JanithChandula/Weight_Scale/20200301_212428.jpg

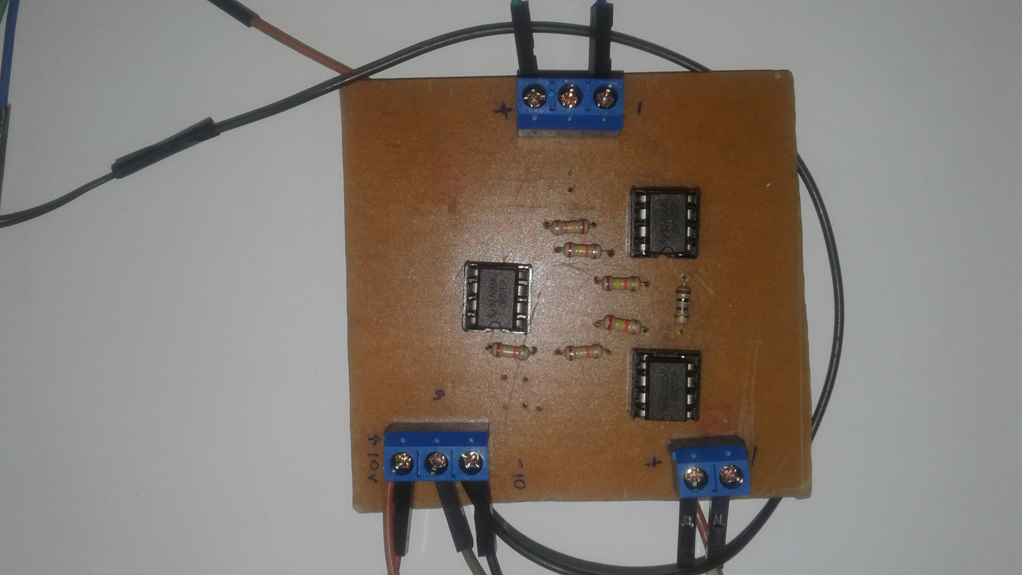
20200301_212428.jpg
