JanithChandula/Weight_Scale/20200221_163328.jpg

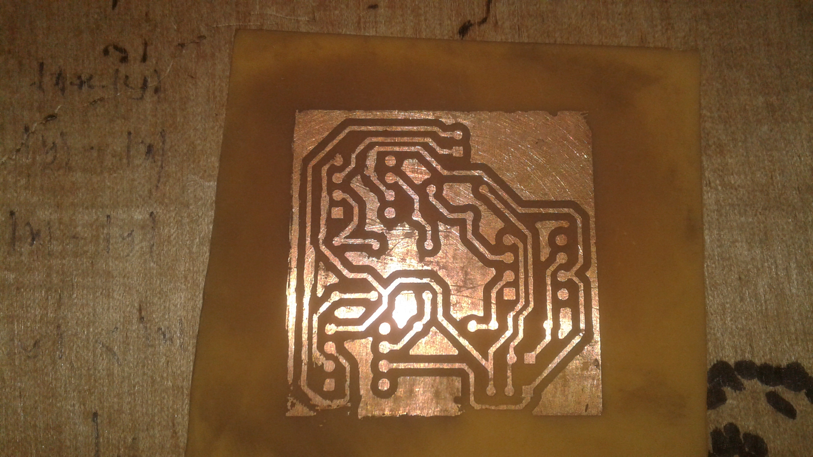
20200221_163328.jpg
