JanithChandula/Weight_Scale/README.md

# Weight_Scale
Developed a weight scale using Atmega 328p to measure weight up to 5 kg
