JanithChandula/Weight_Scale/20200222_132628.jpg

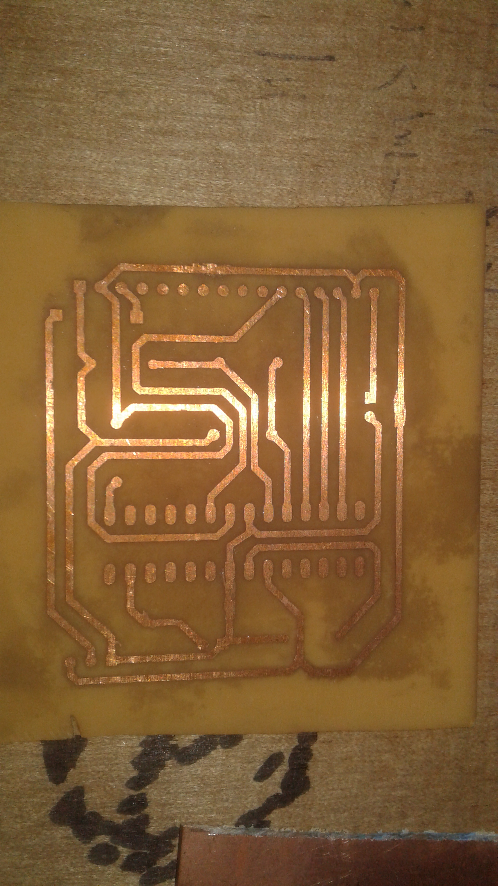
20200222_132628.jpg
