JanithChandula/Weight_Scale/20200301_211958-1.jpg

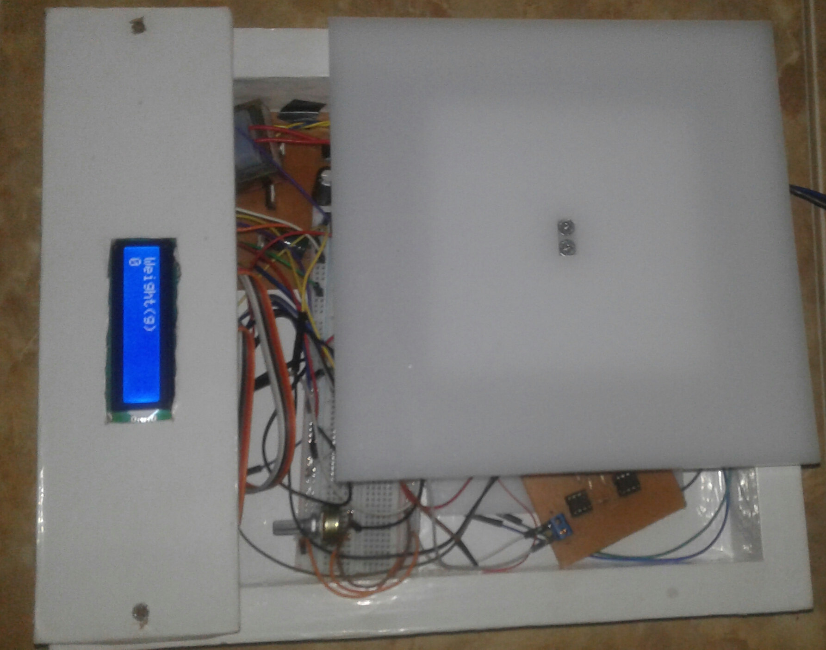
20200301_211958-1.jpg
