JanithChandula/Weight_Scale/20200301_212128-1.jpg

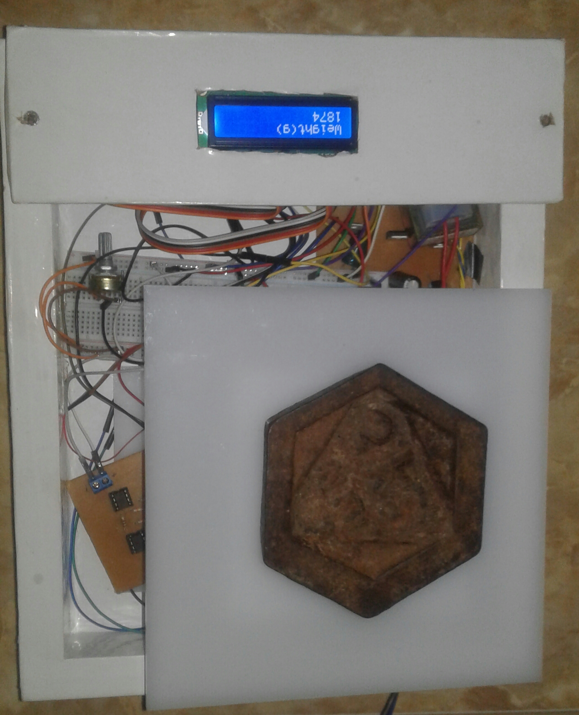
20200301_212128-1.jpg
