JanithChandula/Weight_Scale/20200301_212612.jpg

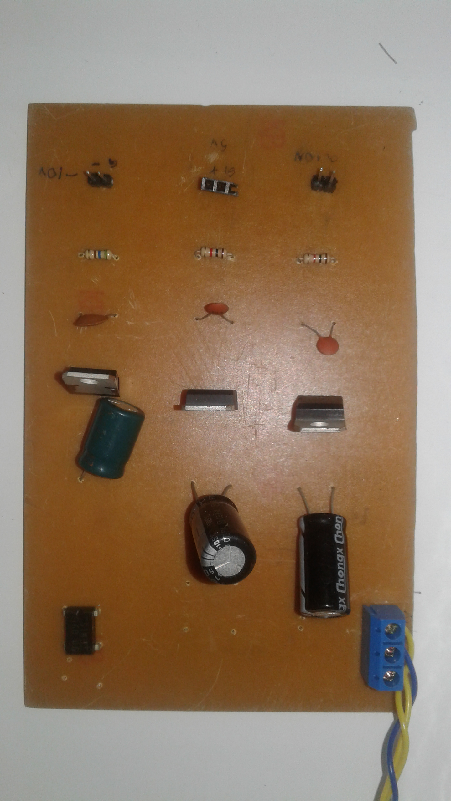
20200301_212612.jpg
