JanithChandula/Weight_Scale/20200301_212658.jpg

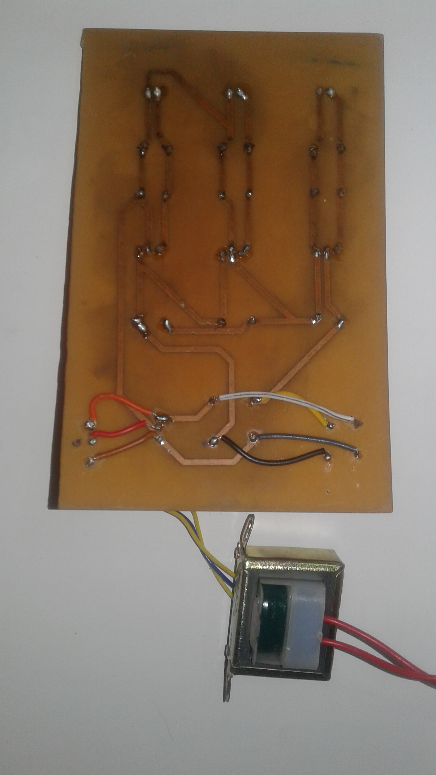
20200301_212658.jpg
