JanithChandula/Weight_Scale/circuit.jpg

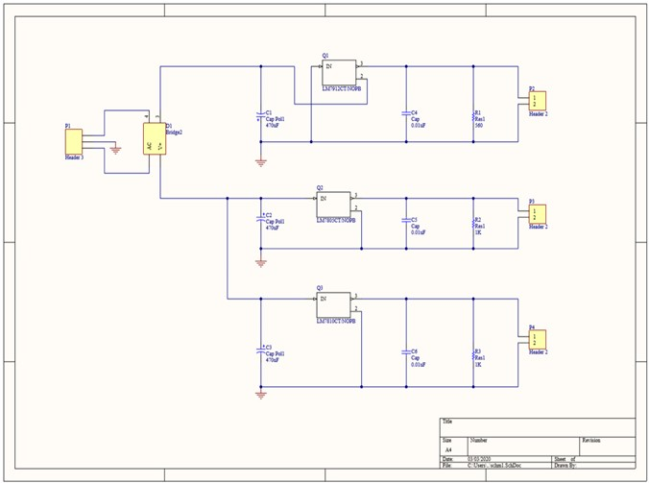
circuit.jpg
