JanithChandula/Weight_Scale/pcb of the microcontroller circuit.png

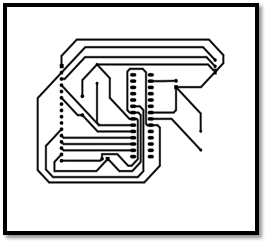
pcb of the microcontroller circuit.png
