JanithChandula/Weight_Scale/pcb.png

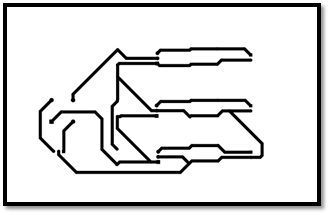
pcb.png
