JanithChandula/Weight_Scale/Schematic of the amplifier circuit.png

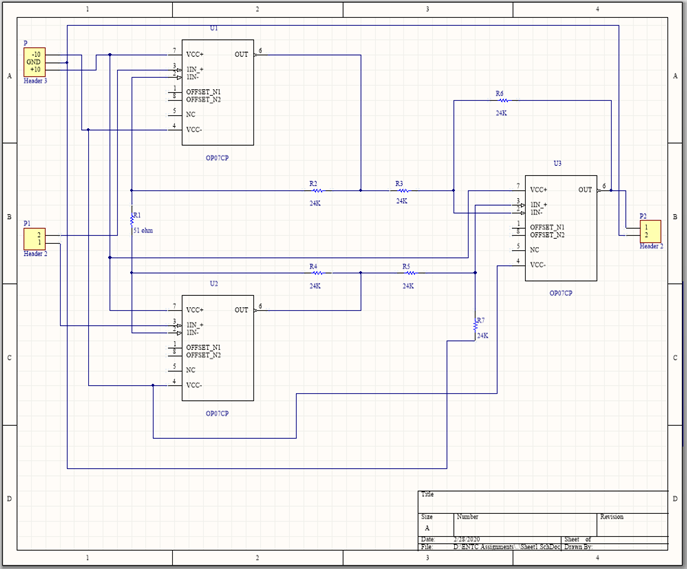
Schematic of the amplifier circuit.png
